applefi87/momenest/(commit log)

2026-07-11 feat: EnvMonitor 初版 — ESP32 環境監測 (LovyanGFX + SHT45/DS18B20/土壤/水位, 非阻塞1Hz時序)
2026-07-11 feat: 雲端上傳 — ESP32 WiFi+HTTPS 每10秒上傳, Cloudflare Worker+D1 API 與儀表板
2026-07-11 Feat: 新增上傳雲端功能
2026-07-11 fix: 上傳JSON組字改用 if/else (三元運算子兩側回傳型別不同致編譯錯誤)
    [EnvMonitor.ino]
2026-07-11 chore: wrangler.toml 改用 example 範本, 實際設定檔 (含 database_id) 不入版控
2026-07-11 docs: 記錄 ILI9488 SDO 不能接的硬體缺陷 (SDO 不三態會壓死共用MISO, 觸控讀不到)
2026-07-12 Fix:把佔用關鍵 pin 的調整掉
2026-07-12 Feat: 為了增加感測水位器，調整成只跑讀取瞬間
2026-07-12 Feat: 增加不同功能的測試包
2026-07-13 Feat: 增加土壤偵測的迅速通電功能
2026-07-13 DOC: 增加說明等文件內容
2026-07-13 Fix: 針對該感測器全通/否的優化,設定合適的感測範圍
2026-07-13 Feat: 可透過螢幕調整土壤溼度與水位的校正值
2026-07-13 feat(esp32): 多語系文字表 lang.h(JSON) 與 i18n 模組
    - lang.h 內嵌 JSON，直接編輯即可改文字/新增語言
    - i18n.cpp 用 ArduinoJson 解析，語言選擇存 NVS
    - 中文用 LovyanGFX 內建 efontTW_16，英文用內建字型
2026-07-13 refactor(esp32): 拆出腳位設定/螢幕硬體/主題模組
    - config.h: 感測器腳位與量測時序參數
    - display_hw.*: LGFX 硬體設定；fix: 面板顏色反相 (pcfg.invert=true)
    - theme.h: 深色主題色票與版面座標
    [config.h, display_hw.h, theme.h]
2026-07-13 refactor(esp32): 感測與校準模組化
    - sensors.*: 1Hz 非阻塞量測時序內聚於 sensorsLoop()
    - fix: ADC attenuation 誤放在 loop 每圈重設，改為 setup 一次性設定
    - fix: 類比讀取改 5 次中位數，抑制土壤間歇跳 0
    - 讀到 0 視為感測器未接 (soilValid/waterValid)
    - calibration.*: 校準值預設寫死 + NVS 載入/儲存
    [calibration.cpp, calibration.h, sensors.cpp, sensors.h]
2026-07-13 refactor(esp32): WiFi/上傳模組化
    - 無效讀值 (土壤/水位=0) 改上傳 null，與溫濕度 NAN 行為一致
    - 記錄 uploadState 供 UI 狀態圓點顯示
2026-07-13 feat(esp32): 深色質感 UI 重構
    - 主畫面卡片式版面：上排三小卡(溫/濕/水溫)、下兩張全寬卡(土壤/水位)
    - 土壤/水位：大%字 + 百分比橫條 + 原始值小字 + 校準鈕
    - 頂部狀態列：WiFi/上傳狀態圓點 + 右上角語言切換鈕(存NVS)
    - 校準畫面同風格重繪，無效讀值顯示 --
    - EnvMonitor.ino 精簡為 setup/loop 入口
2026-07-13 docs: 新增 CLAUDE.md 程式導覽
    依「想做的事 -> 看哪個檔」整理，改功能不需通讀全部檔案
2026-07-13 docs: 新增 DEV_NOTES.md 開發前必讀
    - 記錄掛載環境 git index 損壞的症狀與標準修復流程
    - 掛載同步延遲的驗證方式
    - CLAUDE.md 開頭加上必讀指引
2026-07-14 docs(esp32): README 更新依賴函式庫與校準說明
    - 函式庫清單加入 ArduinoJson (lang.h 多語系解析)
    - Partition Scheme 註記中文字型 flash 不足時改 Huge APP
    - 程式架構段落指向模組化後的檔案與 CLAUDE.md/DEV_NOTES.md
    - 待校正項目改為螢幕校準操作說明
2026-07-14 fix(esp32): 開機黑白刷新消除面板殘影
    舊韌體反相亮底長時間顯示靜態畫面造成液晶暫時極化殘留，
    深色主題下隱約可見舊畫面。開機做 3 次黑白交替全屏刷新加速消除；
    現象與對策記入 DEV_NOTES.md
    [ui_main.cpp]
2026-07-14 fix(esp32): 移除無效的開機殘影刷新
    短暫黑白閃無法消除液晶極化殘影，屬安慰劑；改為文件指引
    診斷/恢復工具，DEV_NOTES 更新判讀與恢復方式
    [ui_main.cpp]
2026-07-14 feat(esp32): 螢幕殘影診斷/恢復測試工具
    獨立燒錄：全屏灰階最易現形殘影，觸控切換灰50/25/75%%、
    白黑紅綠藍、恢復模式(黑白500ms交替去極化)；
    模式名稱顯示1秒後抹除避免文字自身殘留
2026-07-19 fix: 修復上次同步造成的檔案截斷損壞
    EnvMonitor.ino 結尾混入大量空位元組、CLAUDE.md/README.md/ui_main.cpp
    在行中間被截斷，皆為掛載同步延遲造成的內容遺失（見 DEV_NOTES.md）。
    以工作目錄的完整內容還原。
    [EnvMonitor.ino, ui_main.cpp]
2026-07-19 refactor(esp32): test tool 資料夾改英文命名並符合 Arduino sketch 規範
    土壤感測器暖機測試/動態校準工具、水位暖機測試三份原始碼從 .txt
    改為 .ino，並各自放入同名資料夾（Arduino IDE 要求 sketch 資料夾
    名稱需與 .ino 檔名一致才能開啟編譯）：
    - 土壤溼度計/偵測速度.txt -> SoilWarmupTest/SoilWarmupTest.ino
    - 土壤溼度計/測試建議的溼度範圍.txt -> SoilCalibrationTool/SoilCalibrationTool.ino
    - 需要減少通電時間/水位.txt -> WaterLevelWarmupTest/WaterLevelWarmupTest.ino
    內容不變，僅重新命名與搬移。
2026-07-19 Refactor: Test tool 資料夾改英文命名
2026-07-19 docs: 新增根目錄 README，補充 cloud 更新同步流程
    新增 README.md 作為專案入口，說明系統架構（ESP32 -> Worker -> D1 ->
    網頁儀表板）、目錄導覽與新手上手順序，方便新加入者快速理解專案全貌
    再深入 EnvMonitor/cloud 各自的 README。
    cloud/README.md 補上「更新流程」章節：API 與儀表板網頁同在
    src/index.js 一個檔案，改完直接 wrangler deploy 即可同步，不需另外
    上傳靜態網頁；並說明 schema.sql 異動需另外手動跑 migration。
2026-07-19 feat(cloud): 儀表板 Apple 質感重設計
    - 深淺色自動切換（prefers-color-scheme），淺色暖灰白/深色純黑
    - 毛玻璃卡片（backdrop-filter blur + 半透明 + 細邊框 + 柔陰影）
    - SF Pro 字族、大號細字數值、tabular-nums 防跳動
    - 每張卡片帶 1h sparkline 迷你趨勢圖（SVG）
    - iOS 式分段控制器（滑動選中底塊動畫）取代舊按鈕
    - 圖表改漸層填色、隱藏圖例改上方彩色圓點標籤
    - 相對時間顯示（「3 秒前」）+ 連線狀態小綠點
    - 土壤/水位支援 ADC→% 校準（localStorage，底部「校準設定」彈窗）
    - 第 5 張卡片（水位）自動展開佔滿整行
    - 數值卡片淡入過渡，無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
2026-07-19 fix(cloud): 圖表無限長高修正 + 手動主題切換鈕
    - 圖表高度失控：Chart.js maintainAspectRatio:false 需搭配固定高度
    容器，canvas 改包在 180px 的 .chart-wrap 內，移除舊的
    width:100%!important 與 height 屬性
    - 新增右上角主題切換鈕（◐ 自動 / ☀︎ 淺色 / ☾ 深色循環，存
    localStorage）；深色系統的裝置從此也能手動切到 Apple 白色主題
    - 深色樣式改由 data-theme 屬性 + prefers-color-scheme 雙軌套用，
    手動選擇優先於系統設定
    - 圖表刻度色移除 canvas 內無效的 var(--tick-color)，改依主題判斷；
    切換主題與系統深淺變化時圖表即時重繪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
2026-07-19 refactor(cloud): Worker 拆分為多模組
    - src/api.js：D1 讀寫（ingest/data/latest 三個 handler）
    - src/dashboard.html：儀表板改為真正的 HTML 檔，經 wrangler.toml 的
    [[rules]] Text 規則 import 成字串，維護時有語法高亮、不再受
    JS 模板字串跳脫限制
    - src/index.js：只留路由入口
    - wrangler deploy 打包後行為與單檔版完全相同（已驗證 API 與儀表板）
    - CLAUDE.md / cloud/README.md 同步更新檔案導覽
2026-07-19 feat(cloud): 儀表板預設白色主題 + 蘋果中文字族
    - 預設主題改為淺色（Apple 暖灰白），不再跟隨系統；切換順序改為
    淺色 → 深色 → 自動，選擇仍存 localStorage
    - head 內先套用主題再渲染，避免深色系統裝置開頁閃黑
    - 字族補上 PingFang TC（蘋果官方中文字型，Apple 裝置生效）與
    Noto Sans TC 遞補，非蘋果裝置的中文也盡量貼近蘋果字感；
    英文維持 SF Pro（-apple-system）
2026-07-19 feat(cloud): 儀表板多語言（中文/英文）
    - 內建 zh/en 字典，首次進站依瀏覽器語言自動選擇，
    右上角新增語言鈕（中/EN）切換並存 localStorage
    - 靜態文字以 data-i18n 屬性標記統一替換；卡片標籤、圖表 legend、
    校準彈窗、相對時間（56 分鐘前 / 56m ago）、圖表時間軸
    地區格式全部跟隨語言
    - 文案結構仿韌體 lang.h 的字典模式，之後加語言只需擴充 I18N 物件
2026-07-19 fix(cloud): 趨勢線改按真實時間定位，掉線時段留白
    sparkline 與主圖表原本把樣本按索引等距排開、不看時間戳，
    裝置掉線 56 分鐘只剩 4 分鐘資料時，線條位置與時間完全對不上。
    - sparkline X 軸改為 (ts-from)/window 真實時間定位；
    相鄰樣本間隔 > 90 秒（約漏 9 筆上傳，視為掉線）就切段斷線，
    沒資料的時段留白；孤立單點畫小圓點
    - 主圖表在掉線空窗插入 null 斷點並改 spanGaps:false，同樣斷開
    - 修正 sparkline 查詢 limit=60 的截斷 bug：10 秒一筆一小時應有
    360 筆，改為 limit=400
    正常連續資料（10 秒一筆）仍連成順滑曲線不受影響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
2026-07-19 refactor(cloud): 掉線門檻改為上傳週期的倍數變數
    - 斷線判定不再寫死 90 秒，改由 UPLOAD_INTERVAL_SEC（上傳週期，
    需與韌體 config.h 一致）× GAP_FACTOR（容許漏傳倍數）推算
    - sparkline 查詢筆數上限同樣改由上傳週期推算，不再寫死 400
    - 之後韌體調整上傳頻率時，儀表板只需改 UPLOAD_INTERVAL_SEC 一處
2026-07-19 feat(cloud): 主圖表改真實時間軸，離線時段按比例留白
    原本 Chart.js 用類別軸，每筆樣本等距佔一格，斷線 30 分鐘和正常
    10 秒間隔看起來一樣寬，只會「空一小格」。改為 linear 時間軸：
    - X 軸範圍固定為所選查詢區間（1h/24h/7d/30d），資料在哪個時間
    就畫在哪個位置；區間內沒資料的時段（含開頭結尾）整段留白
    - 資料點改 {x: ts, y: value} 形式，掉線空窗仍插 null 斷點斷線
    - 刻度與 tooltip 標題由 timestamp 依語言格式化
2026-07-19 fix(cloud): 儀表板回應加 Cache-Control: no-cache
    未設快取標頭時瀏覽器用啟發式快取，部署新版後使用者仍可能拿到
    數小時前的舊頁面。改為 no-cache（每次向伺服器驗證）。
2026-07-19 Fix: 大尺度下梅顯示連線
2026-07-19 fix(ui): resolve bootloop crash from static color initialization and close preferences cleanly
    [calibration.cpp, i18n.cpp, theme.cpp, ui_main.cpp]
2026-07-19 feat(ui): add visible theme toggle button next to language button
2026-07-19 feat(cloud): 圖表下方顯示所選區間的高/低/均統計
    每張圖表底部新增統計列，隨 1h/24h/7d/30d 切換重算；
    ADC 欄位有校準值時換算成 %，儲存新校準後即時更新；
    標籤走 i18n（高/低/均 ↔ H/L/Avg）。
2026-07-19 feat(esp32): ArduinoOTA 無線韌體更新
    - WiFi 連上後自動啟動 OTA（hostname env-monitor，密碼 OTA_PASS
    加入 secrets.h.example），Arduino IDE 網路埠即可免 USB 上傳
    - netLoop() 每圈處理 OTA 請求，斷線時自動略過
    - README 註明需有 OTA 槽的 Partition Scheme（Huge APP 不支援，
    改用 Minimal SPIFFS 1.9MB APP with OTA）
2026-07-19 feat(esp32): 螢幕保護——無觸控 5 分鐘熄屏，觸控喚醒
    - 逾時黑畫面並停止重繪（量測/上傳照常），也降低面板殘影風險
    - 熄屏時第一下觸控只喚醒不觸發按鈕；編輯畫面熄屏時自動退回主畫面
    - 逾時 SCREEN_TIMEOUT_MS 與背光腳 PIN_TFT_BL 在 config.h：
    目前 BL 硬接 3.3V 熄屏仍微亮，改接 GPIO 填腳位即可真斷背光
2026-07-19 feat(cloud): PWA 支援——手機可安裝到主畫面
    - manifest.webmanifest（standalone 顯示、水滴圖示 SVG+PNG）
    - service worker：網頁殼 network-first、離線退回快取；/api 不快取
    - SVG 圖示（含 maskable）+ 180px PNG（iOS apple-touch-icon）
    - dashboard 加 manifest/theme-color/icon 連結與 SW 註冊
    - wrangler 加 Data 規則 import png；新增 src/pwa.js 集中 PWA 資源
    已驗證四端點 200 與 SW activated。iOS Safari 分享→加入主畫面、
    Android Chrome 會出現安裝提示。
2026-07-20 fix(esp32): OTA 就緒訊息印出 IP 與 hostname
    原本只印 OTA ready，看不到裝置 IP，難以判斷網段或改用
    espota.py 上傳。改印 env-monitor.local 與實際 IP。
    [net.cpp]
2026-07-20 feat(esp32): 主畫面標題改為品牌名
    - zh: 環境監測 → 漫嶼環境監測
    - en: Env Monitor → Momenest Env Monitor
    - 新增「漫」「嶼」二字，重新生成 font_ui.h 子集字型（132→134 字）
2026-07-21 feat(esp32): 主畫面上排改為氣溫/水溫相鄰、濕度分開
    原順序氣溫|濕度|水溫，濕度夾在兩溫度中間；改為氣溫|水溫|濕度，
    兩個溫度並排、濕度移到最後，數值/單位/顏色同步調整。
2026-07-21 feat(cloud): 溫度圖合併氣溫/水溫並固定 5~35，濕度獨立成圖
    - 原溫濕度圖(氣溫+濕度+水溫)拆為兩張：
    溫度圖僅氣溫+水溫，Y 軸固定 5~35°C，比例一致好比較
    濕度自成一張(0~100% 尺度不同，混在一起會壓扁溫度線)
    - 統計列同步拆成溫度/濕度/類比三組
2026-07-21 feat(cloud): 溫度圖 Y 軸改為預設 15~35、超界自動放寬
    固定範圍會把異常高/低溫的線切在邊界看不到。改為預設 15~35°C，
    資料超出時向外取整放寬（低於 15 或高於 35 才擴，正常維持不變），
    兼顧比例一致與異常可見。
2026-07-21 fix(esp32): 關閉 WiFi 省電，修復可上傳卻 ping/OTA 不到
    裝置能每 10 秒主動上傳，但電腦 ARP/ping/OTA 進來時常無回應
    （modem-sleep 淺睡期間不理會 inbound）。本機插電供電，直接
    WiFi.setSleep(false) 讓射頻常開，inbound 可靠。
    [net.cpp]
2026-07-21 feat(esp32): 頂部即時顯示本機 IP
    標題右側以內建 Font0 小字靠右顯示 WiFi IP，方便隨時確認裝置
    實際 IP（免查路由器/接 USB）。純 ASCII 不動中文 VLW；只在 IP
    變動時重畫避免閃爍；動態量測標題寬度確保不蓋到標題；未連線
    時不顯示。
2026-08-03 feat(esp32): 抽出 reading_format 純邏輯模組 + host 單元測試 (TDD)
    把「感測值 → JSON」序列化抽成與硬體無關的純函式，供 WiFi 上傳與
    之後的 BLE Notify 共用，並可在 PC 上用 g++ 編譯執行單元測試。
    - reading_format.h/.cpp：formatReadingJson()，NaN/未接 → null，
    格式與雲端 ingest 相容（%.2f、原始 ADC）
    - tests/：host 單元測試（9 案例，正常/浮點/負值/NaN/未接/全無效/
    截斷語意），run_tests.sh 一鍵編譯執行；與 test tool/ 硬體 sketch
    刻意分開放，測試理念寫在 tests/README.md
    - g++ 實跑 9/9 通過、零警告
2026-08-03 refactor(esp32): net.cpp 上傳改用共用的 reading_format
    移除 netUpload() 內重複的 JSON 手組邏輯，改建 SensorReading 後呼叫
    formatReadingJson()——與之後 BLE 共用同一份、且受 host 單元測試保護。
    輸出格式完全不變。
2026-08-03 feat(esp32): BLE 讀值服務 (NimBLE，與 WiFi 共存)
    手機以 BLE 連線即時取得感測值，設備仍照常 WiFi 上傳雲端。
    - ble.cpp/.h：NimBLE GATT server，readings(感測值 JSON) + status
    (wifi/upload/ip) 兩個 characteristic，Read+Notify；斷線自動重廣播
    - 感測值序列化沿用 reading_format（與 WiFi 上傳同格式、受單元測試保護）
    - config.h 加 ENABLE_BLE 開關；flash 不足可關閉整個子系統
    - EnvMonitor.ino 於 setup 啟動、每量測週期 bleNotify()，皆以 #if 保護
    - 需 Library Manager 安裝 NimBLE-Arduino，Partition 選有 OTA 槽者
    註：NimBLE 硬體膠合需上機驗收（本機無 Arduino 工具鏈）；純序列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
2026-08-03 feat(app): Web Bluetooth 手機 App + BLE 文件
    - app/index.html：Android Chrome 的 Web Bluetooth App，連 env-monitor
    讀 readings/status 並即時顯示；沿用儀表板蘋果風格與校準 % 邏輯
    （沒 native APK 是因無法在此建置/驗證；Web Bluetooth 免建置、Android
    Chrome 原生支援、可加入主畫面）
    - EnvMonitor/BLE.md：GATT 契約（UUID/JSON），設備端與 App 的單一事實來源
    - app/README.md：使用、為何 Web Bluetooth、nRF Connect 驗證流程
    - CLAUDE.md：目錄表與架構補上 reading_format/ble/tests/app
    App 的 UI 與「JSON→卡片」解析管線已於瀏覽器實測（含 null 與校準 %）。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
2026-08-03 fix(esp32): ble.cpp 改用 NimBLE-Arduino 2.x API
    實測安裝的是 NimBLE 2.x：
    - ServerCallbacks onConnect/onDisconnect 簽章多了 NimBLEConnInfo&
    (與 int reason)，1.x 簽章的 override 會編譯失敗
    - 廣播改用 setName() + enableScanResponse()(2.x 不再自動廣播名稱、
    且名稱與 128-bit UUID 需分放廣播/回應封包)
    [ble.cpp]
2026-08-03 feat(cloud): Worker 新增 /ble 路由，託管手機 Web Bluetooth App
    把 app/index.html 以 Text 模組 import (../../app/index.html)，在
    env-monitor.workers.dev/ble 提供 HTTPS 頁面——Web Bluetooth 需安全內容，
    手機 Android Chrome 開此網址即可藍牙直連設備 (app/ 仍為單一來源，不複製)。
2026-08-03 refactor(cloud): BLE App 移入 cloud/src，消除跨目錄 import
    app/index.html → cloud/src/ble-app.html：凡 Worker 託管的頁面都放
    src/（與 dashboard.html 一致），index.js 改本地 import ./ble-app.html，
    移除 ../../app 跨目錄耦合，維護者一看 cloud/ 就知道 /ble 內容在哪。
    - 移除根目錄 app/（README 內容併入 cloud/README.md）
    - cloud/README：新增「兩個網頁前端」說明（資料來源/用途/為何託管於此）
    - CLAUDE.md / BLE.md：路徑與路由同步更新
    - 已部署驗證 /ble 與 / 皆 HTTP 200
2026-08-03 feat(esp32): BLE OTA 韌體更新 (設備端) + TDD
    手機透過藍牙傳 .bin 更新韌體，不必對設備插 USB。
    - ota_protocol.*：control 封包解析 + 進度% 純邏輯，host 單元測試
    (test_ota_protocol.cpp，共 17 例，含 LE 解碼/邊界/溢位)
    - ble_ota.*：NimBLE control/data characteristics + Update 庫寫入 OTA 分區；
    data 用 Write With Response 天然流控；每 1% notify 進度
    - ble.cpp：setMTU(517)、在同一 service 掛 OTA、斷線 otaHandleDisconnect()
    - EnvMonitor.ino：OTA 期間 otaIsActive() 暫停量測/UI/WiFi 上傳/BLE 推播/
    重連，讓出天線與 RAM (避免 TLS 40KB 峰值搶資源)；uiDrawOta 顯示進度
    - config.h：ENABLE_BLE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
2026-08-03 feat(app): 手機端 BLE OTA — 選 .bin 推送更新 + 進度條
    /ble 頁面連線後顯示「韌體更新」區塊：選 .bin → 開始更新。
    - 讀 .bin 為 ArrayBuffer，寫 BEGIN(size LE32) → 分塊 512B 灌 ota_data
    (writeValueWithResponse 天然流控) → END；進度條依已送位元組即時 %
    - 訂閱 ota_control notify 顯示設備回報 (錯誤/中止碼)
    - 失敗自動送 ABORT，提示舊韌體不受影響、可重試
    - 成功後設備重開機→斷線，視為完成提示重連確認
    已於瀏覽器驗證：UI 渲染、進度條、BEGIN 封包 LE 編碼 [1,232,3,0,0]
    與設備端 parseOtaControl 單元測試一致 (協定契約對齊)。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
2026-08-03 feat(esp32): 標題改「漫嶼環境監測器」，重生字型納入「器」
    中文標題加「器」，此字不在原 VLW 子集，重跑 generate_vlw.py
    更新 font_ui.h（134→135 字），否則螢幕該字顯示空白。
2026-08-04 Feat: 增加藍芽功能(含OTA)
2026-08-05 feature: [client] 建立 Kotlin Multiplatform 專案骨架與建置設定
    8 個模組：core:{protocol,ble,data,designsystem,testing}
    + feature:{monitor,ota} + app，相依方向 app -> feature -> core。
    - 版本統一在 gradle/libs.versions.toml（AGP 8.7.3 / Kotlin 2.0.21
    / Compose BOM 2024.12.01 / Hilt 2.52），各模組一律用 alias 引用
    - gradle-wrapper.jar 刻意不進版控（二進位），由 Android Studio
    開啟資料夾或 gradle wrapper 產生
2026-08-05 feature: [client] core:protocol — KMP 協定層、OTA 編排與 115 個測試
    改成真正可用的 KMP：commonMain 移除所有 JVM 專屬 API（java.util.UUID、
    java.util.zip.CRC32），改用自訂 BleUuid 與自行實作的 CRC32。原本宣告了
    iOS target 卻 import java.* —— Android 編得過是因為只編 jvm target，
    真的編 iOS 會直接失敗，多平台形同虛設。
    新增：
    - OtaUploader：BEGIN -> 分塊 -> END 的完整編排，任何失敗路徑都補送 ABORT
    讓設備 Update.abort()，舊韌體不受影響
    - OtaControlPacket / OtaReportDecoder：封包編解碼，逐位元組對稱於韌體的
    parseOtaControl()；END 可帶 CRC32（向後相容 1-byte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
2026-08-05 feature: [client] core:ble — Android BLE 轉接器與完整連線流程
    修好「連得上但沒有任何資料」：原本 onServicesDiscovered 之後直接註記
    「暫略以求編譯通過」，從未開啟 notify，uploadFirmware 也是 TODO()。
    新增 AndroidGattTransport：把回呼式 BluetoothGatt 包成協程 / Flow，
    處理 API 33 前後的 writeCharacteristic / writeDescriptor 差異，
    所有操作經 GattOperationQueue 序列化（Android GATT 同時只允許一個操作）。
    AndroidEnvMonitorClient 補上完整流程：
    - 掃描只用 SERVICE_UUID 過濾，移除原本的裝置名稱二次比對
    （Android 12 起無定位權限時 device.name 常為 null，會掃到卻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
2026-08-05 feature: [client] core:data / designsystem / testing — 持久化、設計系統、測試替身
    - core:data：DataStore 存土壤/水位校準值。選 DataStore 而非 SharedPreferences
    是因為它非阻塞且天生是 Flow，與 UI 的響應式資料流合拍
    - core:designsystem：Compose 主題與共用元件（ReadingCard / StatusDot /
    SectionCard / OtaProgressBar），配色與尺寸逐一對照網頁版 ble-app.html 的 CSS，
    讓 App 與網頁看起來是同一個產品
    - core:testing：共用測試替身。刻意手寫 fake 而非用 mock 框架——OTA 是有狀態的
    來回對話，mock 設定寫錯時測試依然綠燈，測到的是自己的假設而非程式碼
    一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
2026-08-05 feature: [client] feature:monitor — 即時讀值畫面
    原本 ViewModel 的 tiles 寫死 emptyList()、otaSupported 寫死 false，
    畫面只有標題與一顆按鈕。
    補上：
    - ReadingTileMapper：讀值 + 校準 -> 五張卡。有校準顯示百分比，沒校準老實
    顯示原始 ADC（硬套猜測的預設校準會給出看似精準卻錯誤的數字）；
    無資料顯示「--」而非 0，避免使用者以為真的量到 0
    - StatusLineFormatter：連線狀態 + 設備 WiFi 狀態的文案。BLE 通不代表雲端
    上傳正常，兩段分開顯示才看得出是哪一段有問題
    - MonitorViewModel：combine 設備四條資料流 + 讀值 + 校準值，錯誤轉成畫面訊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
2026-08-05 feature: [client] feature:ota — 韌體更新畫面
    原本只有 Text("OTA Screen Stub")。
    - FirmwareReader：從 SAF 讀出韌體位元組，8 MB 上限避免誤選大檔 OOM。
    介面參數用 String 而非 android.net.Uri，讓 ViewModel 保持平台中立、
    在純 JVM 測試裡不需要任何 Android 模擬
    - OtaMessages：OtaEvent -> UI 狀態的純函式 reducer。每種失敗都必須說明
    「舊韌體不受影響」——使用者最怕的是把設備刷壞了
    - OtaViewModel：選檔、開始、取消、重設。傳輸中重複按不會啟動第二條傳輸
    （兩個傳輸同時灌 flash 一定會把韌體寫壞）
    - OtaScreen：無狀態，進度條 / 按鈕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
2026-08-05 feature: [client] app — 導覽、藍牙權限閘門與 DI 組裝
    單一 Activity + Compose Navigation，兩個目的地（讀值、韌體更新）。
    這層不放任何業務邏輯，只做組裝——邏輯全在 core/ 與 feature/ 裡才測得到。
    - BluetoothPermissionGate：用 BlePermissions.runtimePermissions(SDK_INT)
    取得清單後一次請求。放在導覽之外而不是每個畫面各自檢查，避免出現
    「A 畫面檢查了、B 畫面忘了」的漏洞
    - targetSdk 35 起系統強制 edge-to-edge，統一在根 Surface 補 safeDrawing inset
    - App 圖示暫用系統內建的 ic_dialog_info（尚未做自製圖示）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
2026-08-05 docs: [repo] 文件重整 — CLAUDE.md 改為 README_ai.md，補上 client 說明
    CLAUDE.md -> README_ai.md：不只 Claude 一種 AI（與人類協作者）需要讀架構
    導覽。CLAUDE.md 保留成一行 @README_ai.md 轉接，讓 Claude Code 仍會自動載入。
    - client/README.md：環境需求、建置、跑測試、安裝、使用方式、測試涵蓋表、
    已知限制，以及與網頁版的功能差異對照
    - client/ARCHITECTURE.md：模組相依圖、三層分離的理由、埠與轉接器設計、
    OTA 傳輸流程與三道安全保障、測試策略、加一個平台要做什麼
    更新：
    - README.md：系統架構圖補上 BLE 這條路徑，說明為何叫 c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
2026-08-05 chore: [client] 忽略 Kotlin 2.0 / KMP 的建置暫存目錄
    .kotlin/ 與 .artifacts/ 由 Gradle sync 產生，內含絕對路徑，
    換機器或搬資料夾就失效，不該進版控。
